ghiffa08/weather-station-agrinex/docs/laporan/assets/01_login_page.png

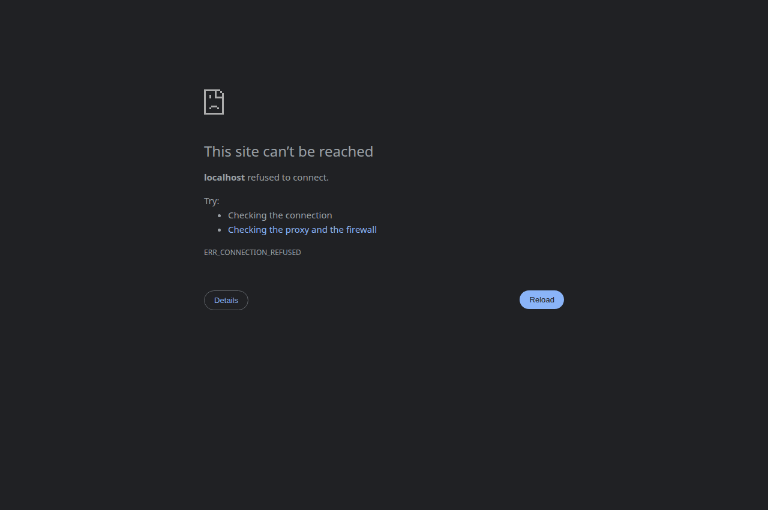
docs/laporan/assets/01_login_page.png
