ghiffa08/weather-station-agrinex/docs/references/zhafira_anemometer/Gambar Produk/PCB TERTUTUP-01.png

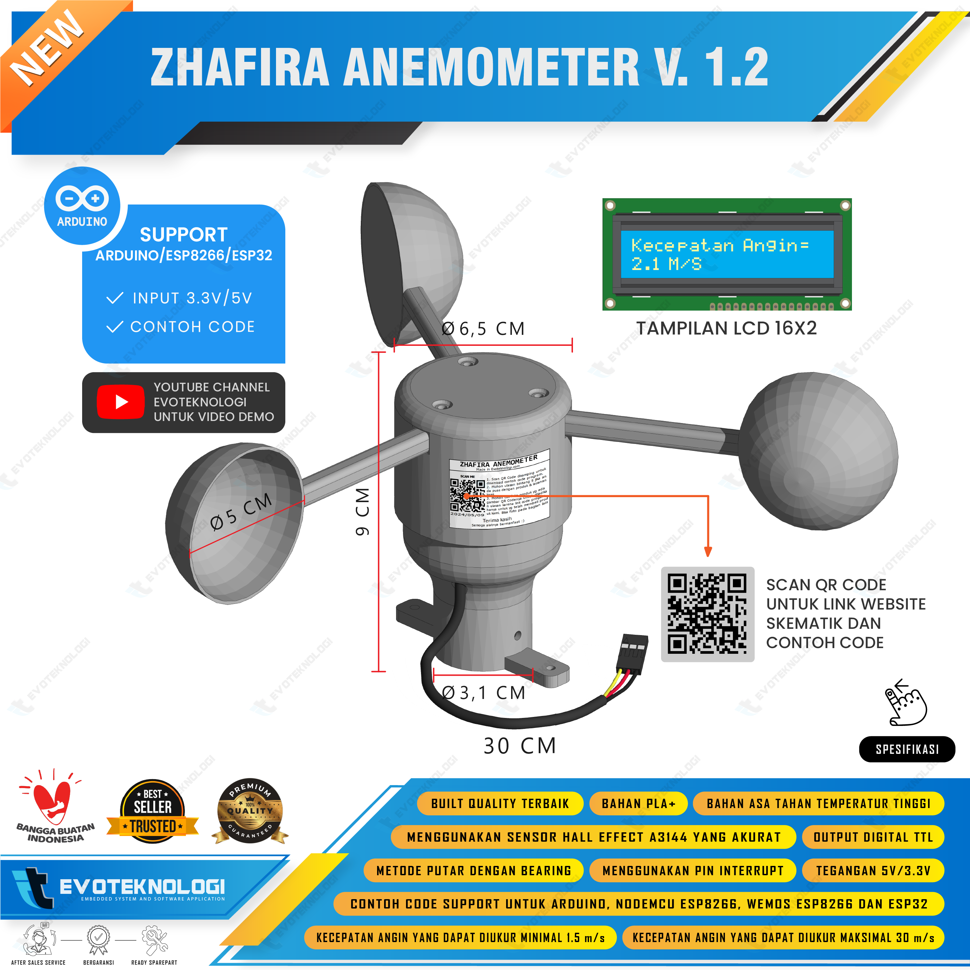
docs/references/zhafira_anemometer/Gambar Produk/PCB TERTUTUP-01.png
