ghiffa08/weather-station-agrinex/docs/references/zhafira_anemometer/Gambar Produk/PCB TERTUTUP-03.png

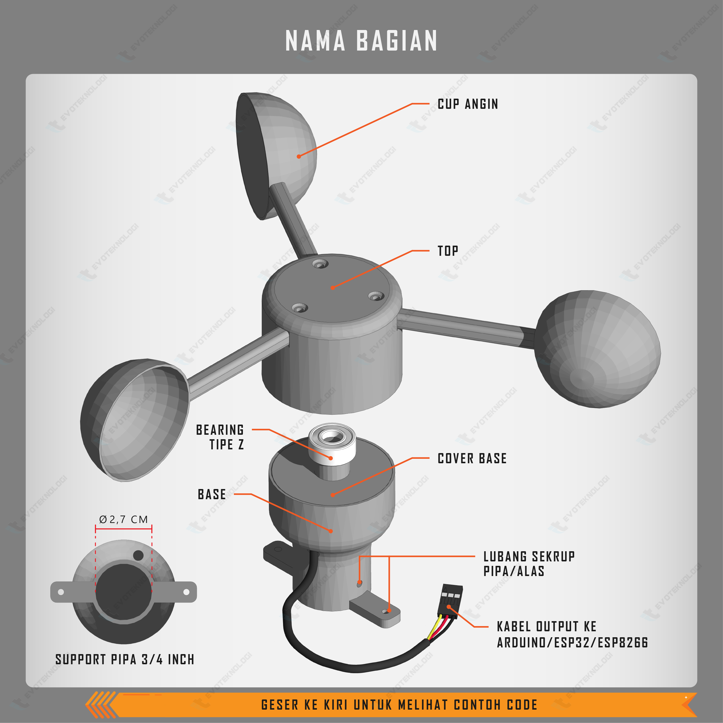
docs/references/zhafira_anemometer/Gambar Produk/PCB TERTUTUP-03.png
