ghiffa08/weather-station-agrinex/docs/references/zhafira_anemometer/Gambar Produk/PCB TERTUTUP-04.png

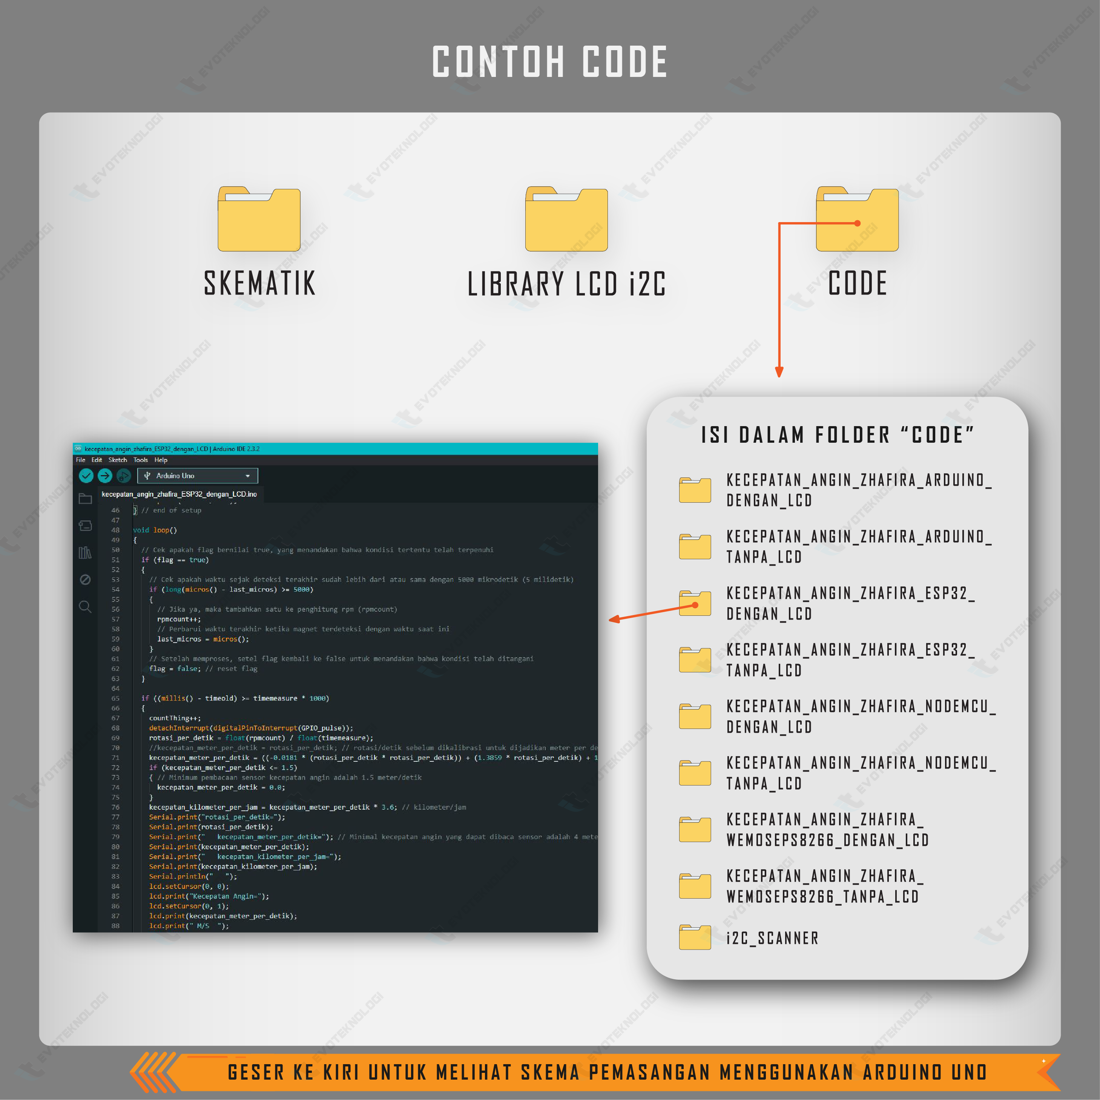
docs/references/zhafira_anemometer/Gambar Produk/PCB TERTUTUP-04.png
