ghiffa08/weather-station-agrinex/docs/references/zhafira_anemometer/Gambar Produk/PCB TERTUTUP-09.png

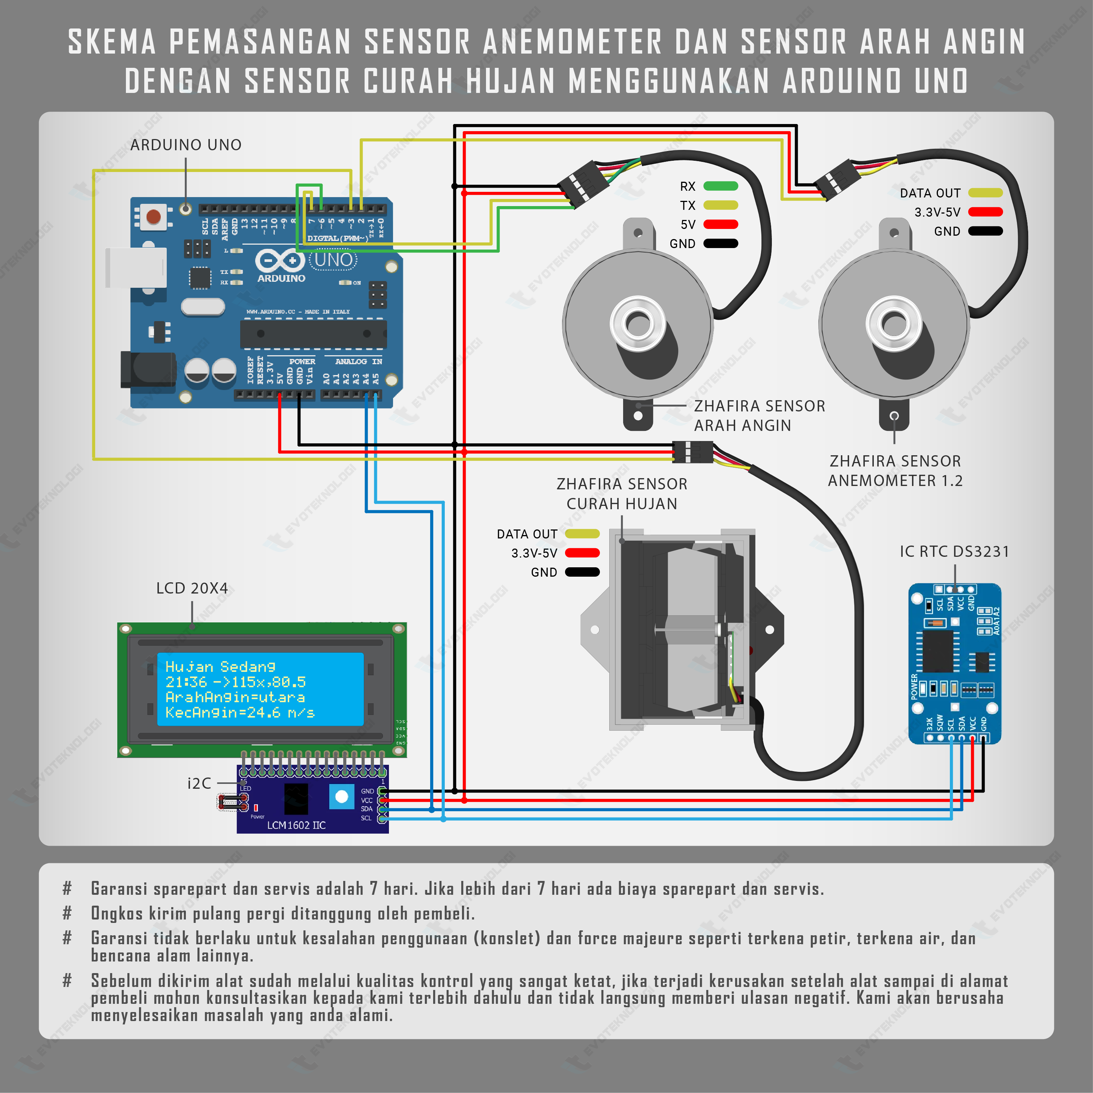
docs/references/zhafira_anemometer/Gambar Produk/PCB TERTUTUP-09.png
