ghiffa08/weather-station-agrinex/docs/references/zhafira_anemometer/Skematik/arduino_uno.png

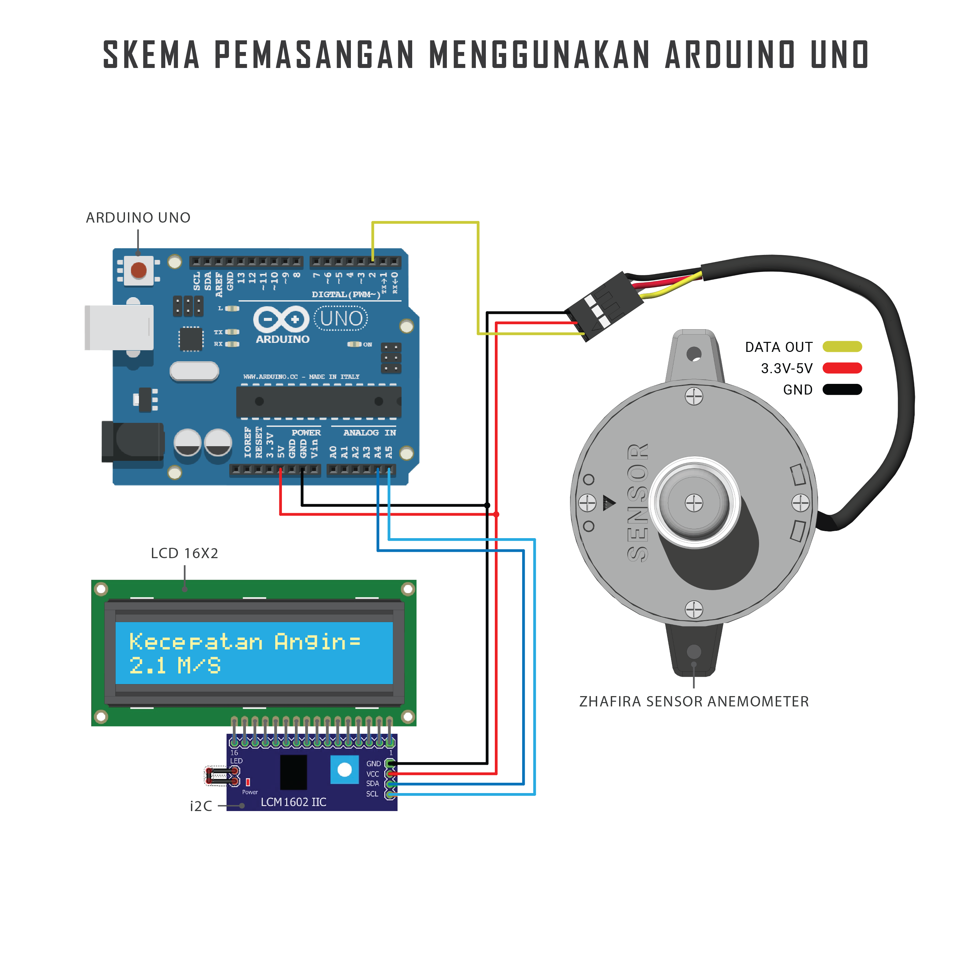
docs/references/zhafira_anemometer/Skematik/arduino_uno.png
