ghiffa08/weather-station-agrinex/docs/references/zhafira_anemometer/Skematik/esp_32.png

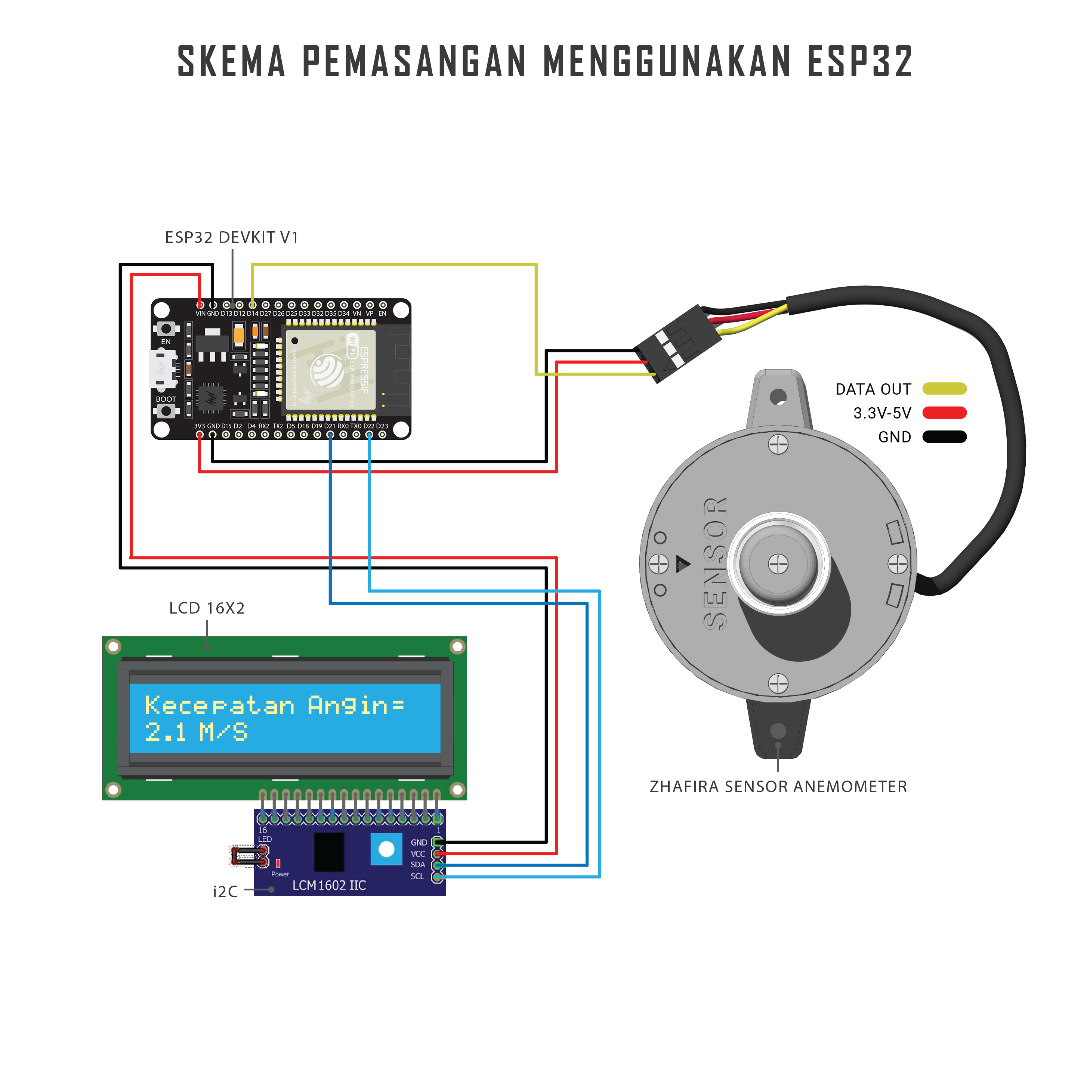
docs/references/zhafira_anemometer/Skematik/esp_32.png
