ghiffa08/weather-station-agrinex/docs/references/zhafira_anemometer/Skematik/kec_angin_arah_angin_curah_hujan_arduino_uno.png

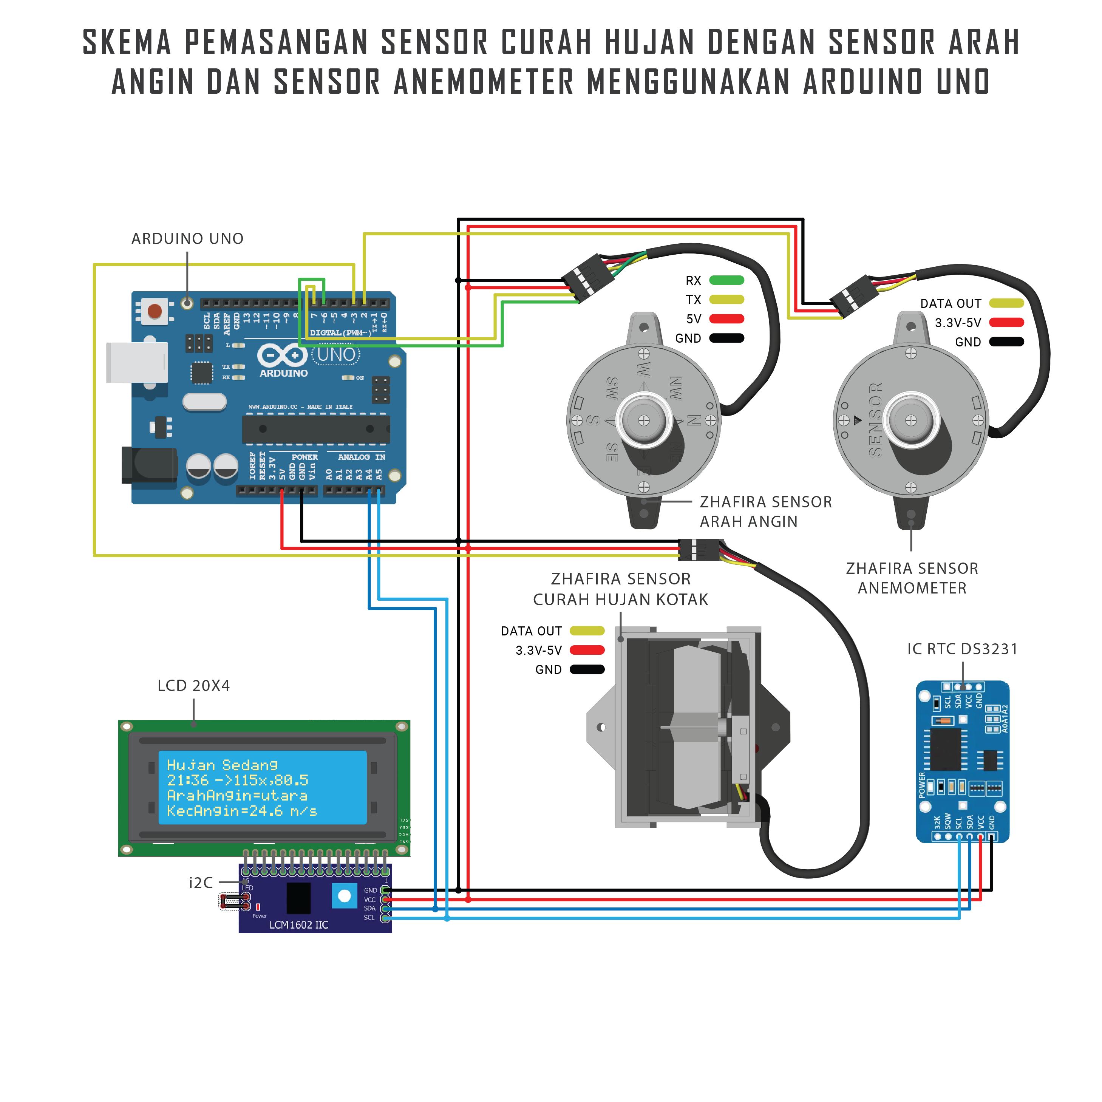
docs/references/zhafira_anemometer/Skematik/kec_angin_arah_angin_curah_hujan_arduino_uno.png
