ghiffa08/weather-station-agrinex/docs/references/zhafira_anemometer/Skematik/nodeMCU_esp8266.png

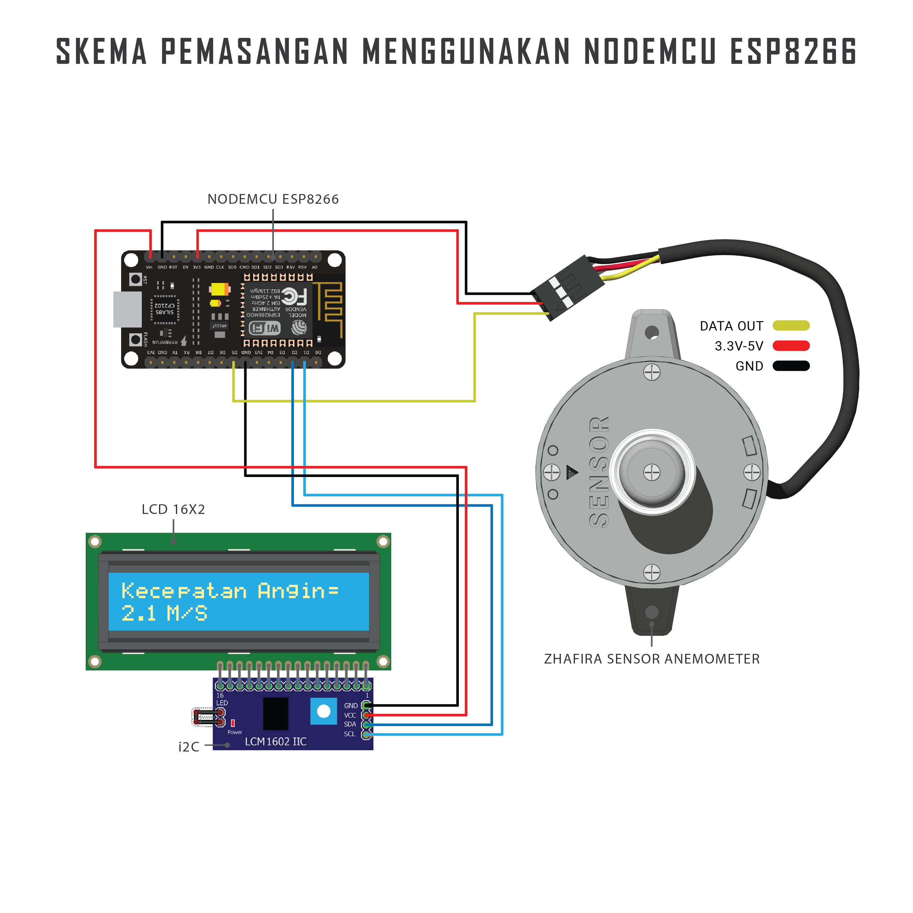
docs/references/zhafira_anemometer/Skematik/nodeMCU_esp8266.png
