ghiffa08/weather-station-agrinex/docs/screenshots/preview-dashboard-full.png

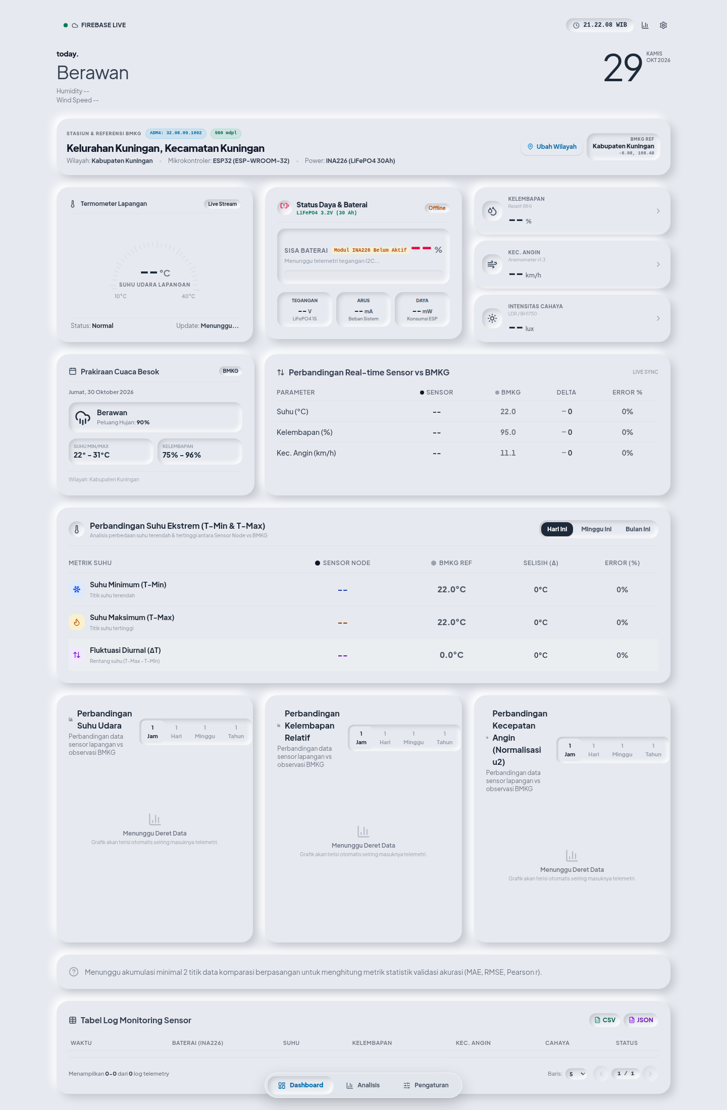
docs/screenshots/preview-dashboard-full.png
