ghiffa08/weather-station-agrinex/docs/references/zhafira_anemometer/Library LCD I2C/link tutorial.txt

https://www.arduinoindonesia.id/2017/02/cara-menambahkan-library-pada-arduino.html
