ghiffa08/weather-station-agrinex/docs/references/zhafira_anemometer/Code/i2c_scanner/link tutorial.txt

Digunakan untuk mengetahui alamat i2c lcd

https://www.nyebarilmu.com/cara-mencari-tahu-alamat-interface-i2c-module-arduino/
