ghiffa08/weather-station-agrinex/docs/references/zhafira_anemometer/Kalibrasi_1.2.xlsx

Kalibrasi Sensor Anemometer
Anemometer Evoteknologi (m/s) | Anemometer Pabrikan (m/s)
0.0 | 0.0
0.1 | 1.1
0.3 | 1.3
0.4 | 1.8
0.5 | 2.3
0.6 | 2.4
0.7 | 2.6
0.8 | 2.9
0.9 | 3.1
1.0 | 3.3
1.4 | 3.8
1.7 | 4.1
2.0 | 4.3
2.2 | 4.5
3.1 | 5.5
7.3 | 9.8
10.0 | 13
12.0 | 16
Cara kalibrasi
https://www.robotikindonesia.com/2019/05/kalibrasi-sensor-menggunakan-trendline-pada-microsoft-excel.html
