ghiffa08/weather-station-agrinex/(commit log)

2026-10-29 feat: initial commit for Agrinex Weather Station (ESP32/ESP8266 + FreeRTOS + PWA Dashboard)
    [Kalibrasi_1.2.xlsx, data_bmkg_harian.csv, data_node_sensor.csv, deployment_log.csv]
2026-10-29 style: clean action buttons to concise Reset, Simpan, and short action labels
2026-10-29 fix(firmware): include INA226 battery telemetry in Firestore payload and update rules
    [main.cpp]
2026-10-29 fix(firmware): sync I2C stabilization, auto-reconnect, and /api/sensors from local-project
    [config.h, main.cpp, web_portal.h]
2026-10-29 refactor: relocate Cloud/Local IP stream switcher and diagnostics to Settings page
2026-10-29 fix(firmware): disable deep sleep to keep WiFi and web server alive 24/7 for local IP testing
    [device_config.h, main.cpp]
2026-10-29 fix(firmware): resolve duplicate CORS headers in WebServer API endpoints
    [web_portal.h]
2026-10-29 fix(sensors): align BH1750, Anemometer noise filter, and DHT22 calibration with local-project
    [device_config.h, main.cpp, web_portal.h]
2026-10-30 fix(i2c-anemo): implement I2C bus recovery, boot stabilization, retries for RTC/BH1750, and pulse-width filter for anemometer
    [main.cpp, web_portal.h]
2026-10-30 feat(auth-settings): add minimalist auth, persistent session, run-once wizard, chart responsive fixes, and inline user management with admin seeder
    [main.cpp, web_portal.h]
2026-10-31 docs & fix: set principal researcher to Haikal Jibran Al-Ghiffarry and frame as research project
2026-10-31 docs: integrate hardware schematic circuit, PCB layout, and BOM into research documentation
