ghiffa08/weather-station-agrinex/(notices)

Notices in the files:
README.md:
License: MIT
